Senior-Design-Pool-Shark/ECE4950_Pool-Shark/README.md

# ECE4950_Pool-Shark
Project updates for Senior Design implementations, Clemson ECE 4950 Team 15
