Senior-Design-Pool-Shark/ECE4950_Pool-Shark/Project_2/Description.md

Project 2 of ECE 4950

Goals: 
 - Utilize MATLAB to interface with a camera and recognize sticker shapes and colors
 - Create a website to share project progress
 - Develope a prototype of the final design
