Senior-Design-Pool-Shark/ECE4950_Pool-Shark/Project_3/Safety_Project3.odt

Function | Potential Failure Mode | Effect | Cause | Severity | Occurrence | Detection | RPN | Mitigation
Motor moves pointer to target | Pointer overshoots or undershoots | Missed target, user confusion | Poor PID tuning | 7 | 5 | 4 | 140 | Tune PID gains, add position feedback
Rail movement | Jamming or stalling | Incomplete motion, system halt | Debris or misalignment | 6 | 4 | 3 | 72 | Clean rail, align track, add limit switches
Electrical system | Overcurrent or overheating | Damage to motor or driver | Excessive load or poor ventilation | 8 | 3 | 5 | 120 | Add thermal cutoff, fuse, monitor current
GUI selection | Wrong target selected | Incorrect motion | Software bug or user error | 5 | 3 | 4 | 60 | Validate input, add confirmation step
Mounting | Pointer detaches during motion | Safety hazard | Weak adhesive or loose fasteners | 9 | 2 | 6 | 108 | Use mechanical fasteners, test under load

Severity Down/ Occurrence Right | 1 - Rare | 2 - Unlikely | 3 - Possible | 4 - Likely | 5 - Frequent
9 - Catastrophic | | Pointer detachment
8 – Very Serious | | | | | Overcurrent/Overheating
7 - Serious | | | | | Overshoot/Undershoot
6 - Moderate | | | | Rail jamming
5 - Minor | | | GUI selection error
