Senior-Design-Pool-Shark/ECE4950_Pool-Shark/Project_3/Linear Rail System.docx

https://www.youtube.com/watch?v=IySOT4QmRbY

Throwing the screenshots in here:

3D models:

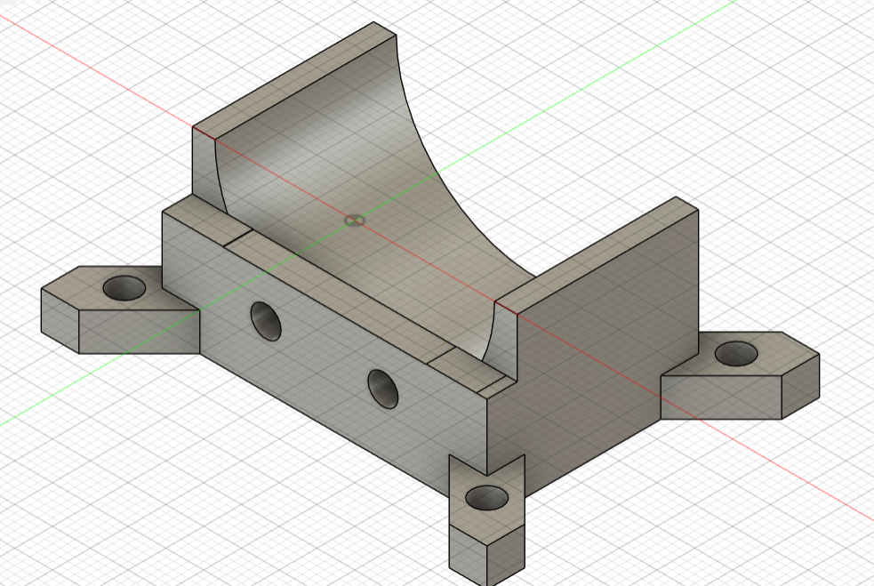
[picture p20: figure]
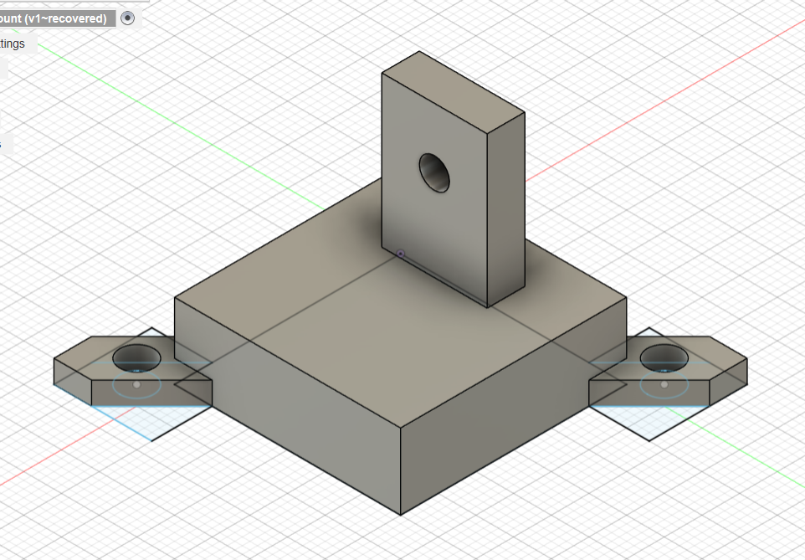
[picture p21: figure]
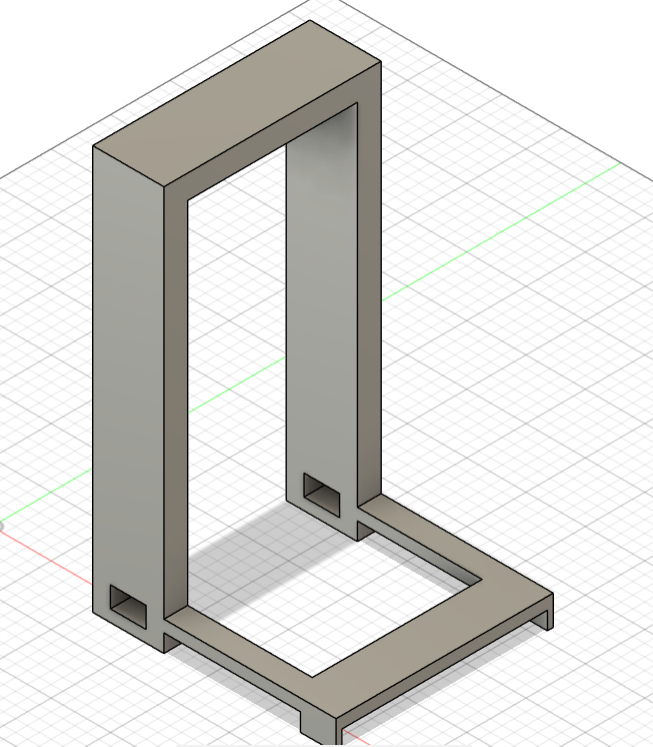
[picture p22: figure]
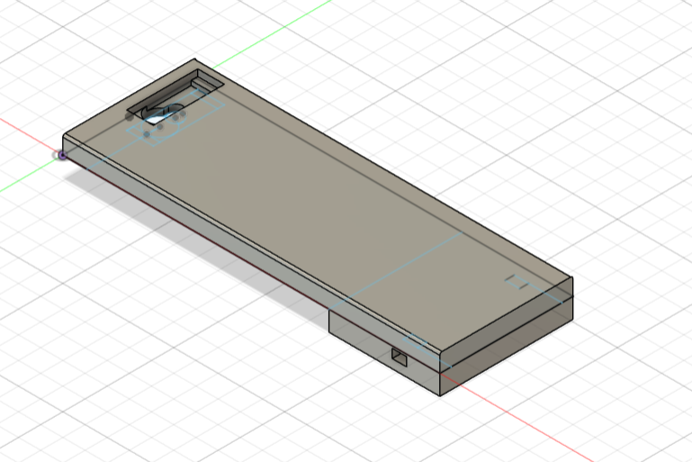
[picture p23: figure]
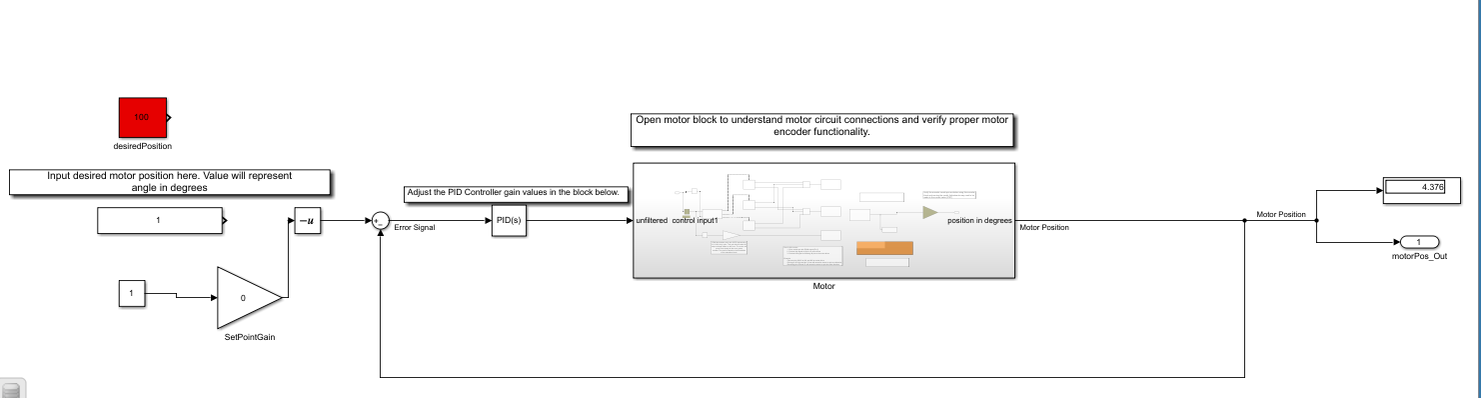
[picture p24: figure]

We don’t technically need the two blocks on the top left but I’m afraid of deleting them before the demo.
