Senior-Design-Pool-Shark/ECE4950_Pool-Shark/Project_3/StartupFinancialScenarioCalculations.xlsx

Use this spreadsheet for calculations and transfer result to your report.
Change the assumptions to reflect the number of engineers in your company.
Assumptions | Item |  | Yearly Costs |  | Description
10 | engineers in company |  |  |  | Company = 10 Engineers + President + Admin Assitant scenario
$85000 | salary per engineer |  | $950000 |  | Total Salary of engineers, president, staff
0.36 | Fringe |  | $342000 |  | Fringe Benefits (including FICA)
12 | cubicles | 2576 |  |  | Total square feet (including President and admin)
$0.79 | Cost/sq ft/month | $2035.04 |  |  | Building cost per month
 |  |  | $24420.48 |  | Building cost per year
12 | desks, chairs, etc @ $60 | $720 |  |  | Desk and chairs per month
 | (engineers + president + staff) |  | $8640 |  | Desks and chairs per year
12 | computers @ $1500 | $18000 |  |  | Computer
12 | software @ $1000 | $12000 |  |  | Software
 | specialized software | $18000
 | copier, printers | $4000
 | Conf Table | $3888
12 | phones | $420
 |  |  | $64948 |  | Total Furniture
12 | internet and phone | $10080 |  |  | Phone and internet per year
 |  | $4032 |  |  | Long Distance per year
 |  |  | $14112 |  | Total Phone and internet per year
$3000 | per national trip | $6000 |  |  | Out of state travel per month
$200 | local trip | $400 |  |  | In state travel per month
 |  | $6400 |  |  | Total Travel per month
 |  |  | $76800 |  | Total Travel per year
800000 | bank loan | $74725.73542 |  |  | Monthly Payment
 |  | $821983.0897 |  |  | Total Paid to the Bank for the year
 |  |  | $21983.08965 |  | Total Interest Paid in first year
 |  |  | $1494263.57 |  | Total expenses
 |  |  |  |  | Overhead calculations
10 | engineers
75 | % billed |  | $637500 |  | Billable labor
 |  |  | $229500 |  | Fringe on billable labor.
 |  |  | $867000 |  | Total billable
 |  |  | $627263.5697 |  | Overhead Number =
 |  |  |  |  | Total projected expenses - total billable labor
 |  |  |  |  | {= Nonbillable expenses}
 |  |  | 72.35 | % | Overhead rate (145% is a common number cited for businesses of all sizes)
Example of how overhead rate is used:
 | Assume enginneer will spend 1/4 of time on a specific project.
 | Labor cost = salary + fringe = ($55000/4)+($55000/4).36 = |  |  |  |  | $18700
 | Cost you should bill your client = (Labor Cost + Fridge Benefit)* (1+Overhead Rate/100)+5%profit
 |  | = | $33840.67
