Senior-Design-Pool-Shark/ECE4950_Pool-Shark/(list of files, cad)

Other CAD files:
Project_3/Camera+Mount (2).f3d
Project_3/Rail System Demo 1.f3d
Project_4/solenoid bracket v7.f3d
Rail.f3d
