Senior-Design-Pool-Shark/ECE4950_Pool-Shark/Project_1/Resources/servo motor wiring diagram.png

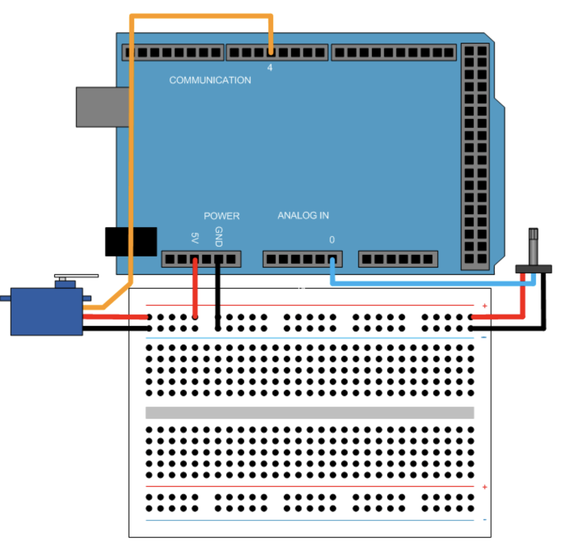
Project_1/Resources/servo motor wiring diagram.png
