Senior-Design-Pool-Shark/ECE4950_Pool-Shark/(commit log)

2025-10-07 Add files via upload
    Added servo motor matlab simulink
2025-10-07 Create build-pages.yml
    Prototype of deploy to pages action
2025-10-07 Update build-pages.yml
    Fixed url formulation for embedded use case
2025-10-31 add weekly project files
    [Camera+Mount (2).f3d, Rail System Demo 1.f3d, StartupFinancialScenarioCalculations.xlsx]
2025-12-03 Rename solenoid bracket v7.f3d to Project_4/solenoid bracket v7.f3d
    [solenoid bracket v7.f3d]
